hpvdt/arbiter/README.md

# Arbiter lighting system
Collection of hardware files for the analog lighting system used on Arbiter
