hpvdt/arbiter/LED Planning Papers_1.jpg

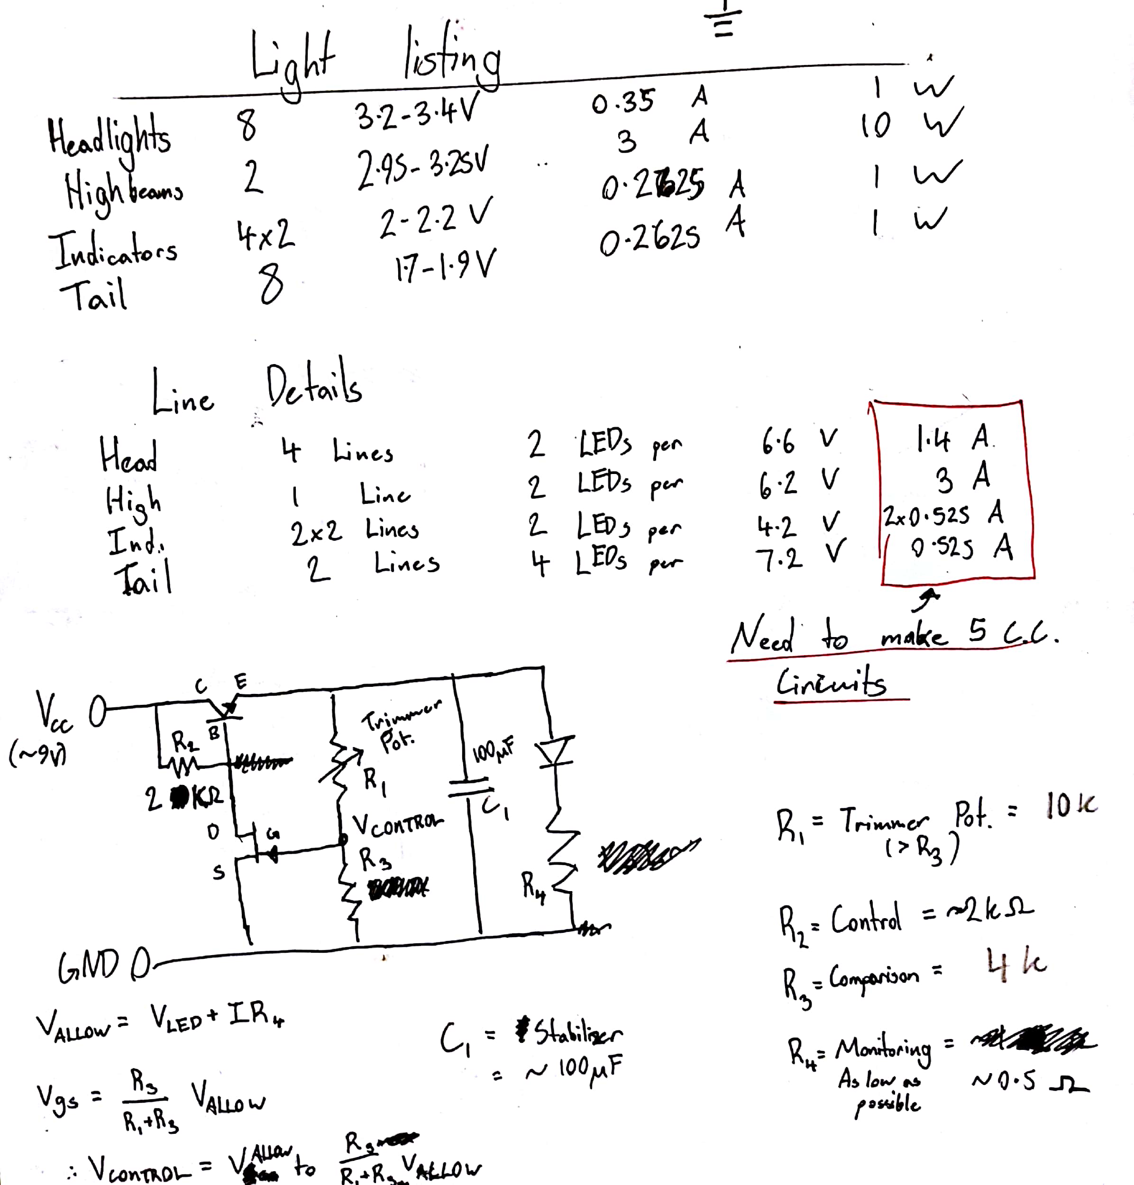
LED Planning Papers_1.jpg
