hpvdt/arbiter/LED Planning Papers_2.jpg

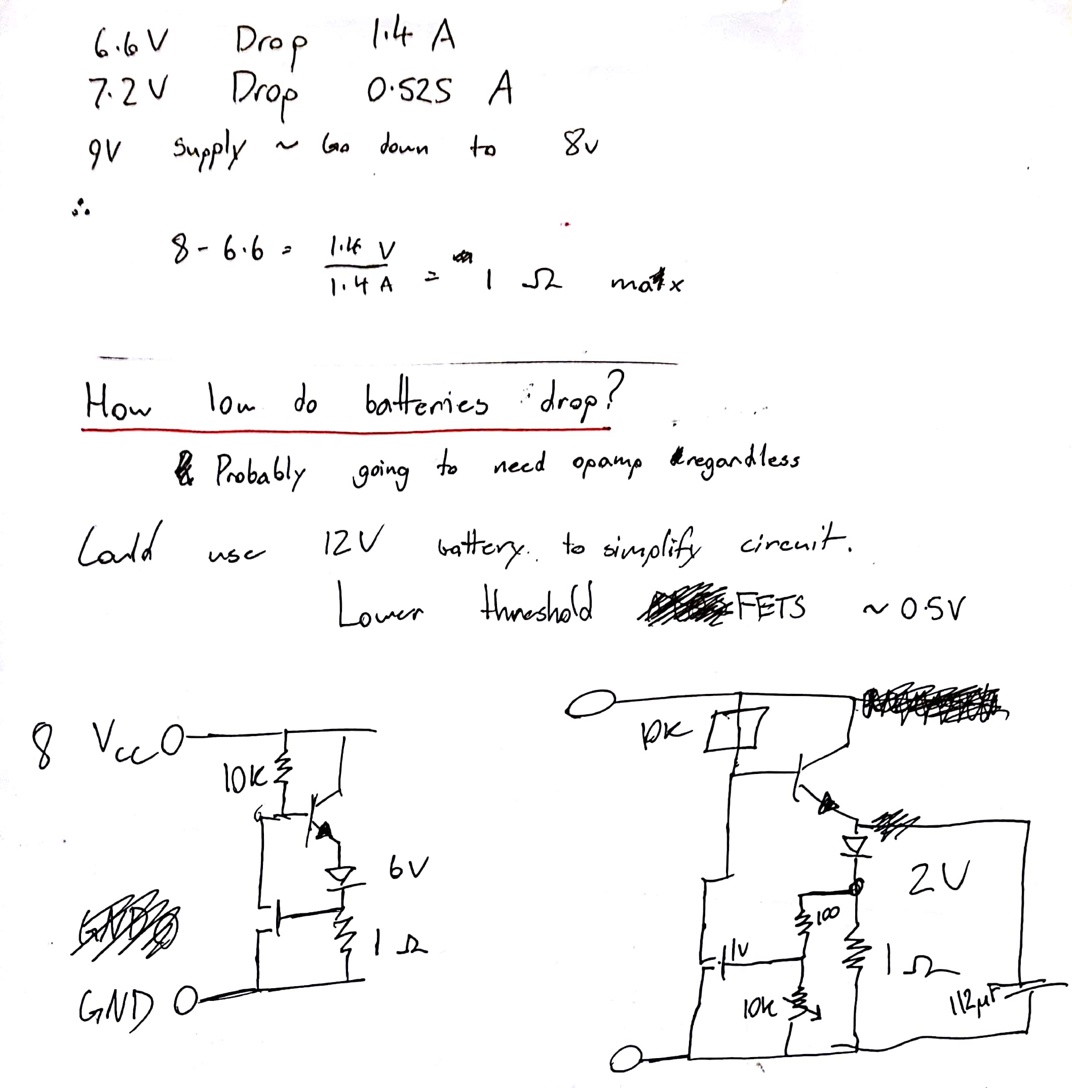
LED Planning Papers_2.jpg
