hpvdt/arbiter/Lighting PCB Image.PNG

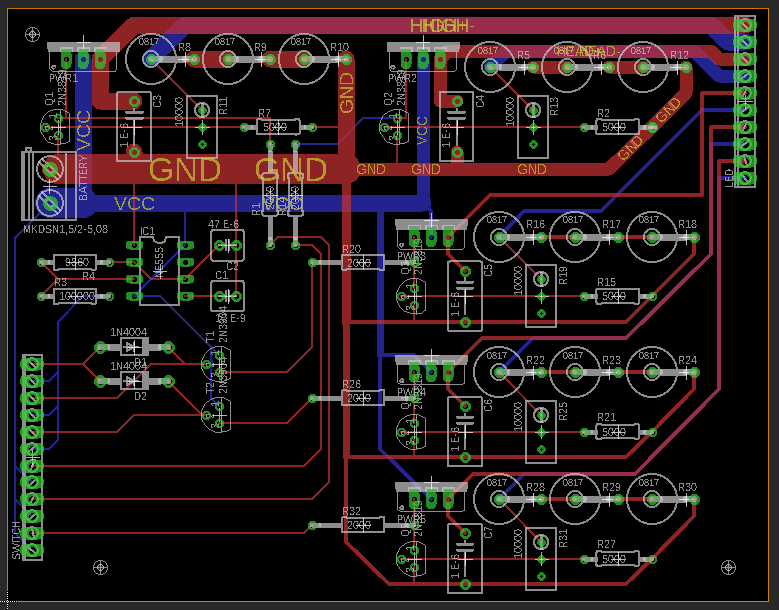
Lighting PCB Image.PNG
