hpvdt/arbiter/LED Configuration.xlsx

 |  | LED V Drop (V) |  |  | Peak Power (W)
Light | LEDs Required | Min | Max | Peak Current (A) | Min | Max |  | Lines Required | LEDs per Line | Max V drop | Total Current to lights | Min V Left across resistors | Max Line resistance | FET Trigger V | Recommended Line Resis. | Max Current at Rec. Resis. | Power across resis | Power Per resis | AVG Resis
Head | 8 | 3.20 | 3.40 | 0.3500 | 1.12 | 1.19 | 9.52 | 4 | 2 | 6.80 | 1.40 | 4.30 | 3.07 | 3.00 | 2.68 | 1.61 | 6.90 | 2.30 | 0.89
High Beam | 2 | 2.95 | 3.25 | 3.0000 | 8.85 | 9.75 | 19.50 | 1 | 2 | 6.50 | 3.00 | 4.60 | 1.53 | 2.31 | 0.96 | 3.25 | 10.17 | 3.39 | 0.32
Left Ind. | 4 | 2.00 | 2.20 | 0.2625 | 0.53 | 0.58 | 2.31 | 2 | 2 | 4.40 | 0.53 | 6.70 | 12.76 | 3.00 | 7.14 | 0.66 | 3.08 | 1.03 | 2.38
Right Ind. | 4 | 2.00 | 2.20 | 0.2625 | 0.53 | 0.58 | 2.31 | 2 | 2 | 4.40 | 0.53 | 6.70 | 12.76 | 3.00 | 7.14 | 0.66 | 3.08 | 1.03 | 2.38
Tail | 8 | 1.70 | 1.90 | 0.2625 | 0.45 | 0.50 | 3.99 | 4 | 2 | 3.80 | 1.05 | 7.30 | 6.95 | 3.00 | 3.57 | 1.31 | 6.15 | 2.05 | 1.19
 |  |  |  |  |  |  |  |  |  |  |  |  |  |  | This resistance means that the current can be set to 0.8 the required (if LEDs are changed) | Limited to possible current given resistance or 1.25 Max LED rated
 | Max | Min
Battery V: | 12.3 | 11.1
 |  |  |  |  |  |  | LED power | Current through shunt | Power dissipated on shunt | Effiency of power deliver to LED (%)
 |  |  |  |  |  | Head | 9.52 | 1.4000 | 4.20 | 69.3877551
 |  |  |  |  |  | High Beam | 19.50 | 3.0000 | 9.00 | 68.42105263
 |  |  |  |  |  | Left Ind. | 2.31 | 0.5250 | 1.58 | 59.45945946
 |  |  |  |  |  | Right Ind. | 2.31 | 0.5250 | 1.58 | 59.45945946
 |  |  |  |  |  | Tail | 3.99 | 1.0500 | 3.15 | 55.88235294
